frtos-wpan/frtos-wpan/doc/evb/e407-odev.jpg

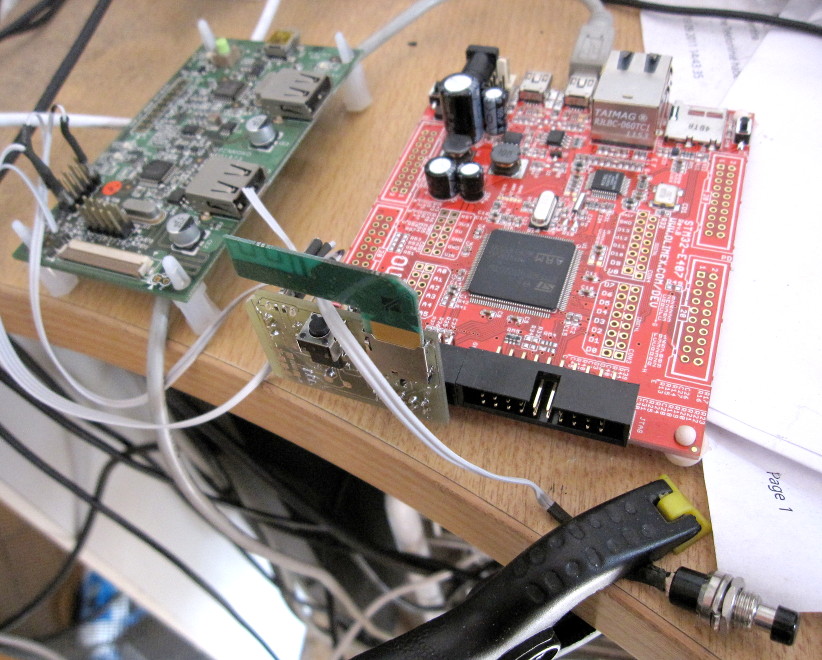
doc/evb/e407-odev.jpg
