frtos-wpan/frtos-wpan/doc/evb/e407-ext.jpg

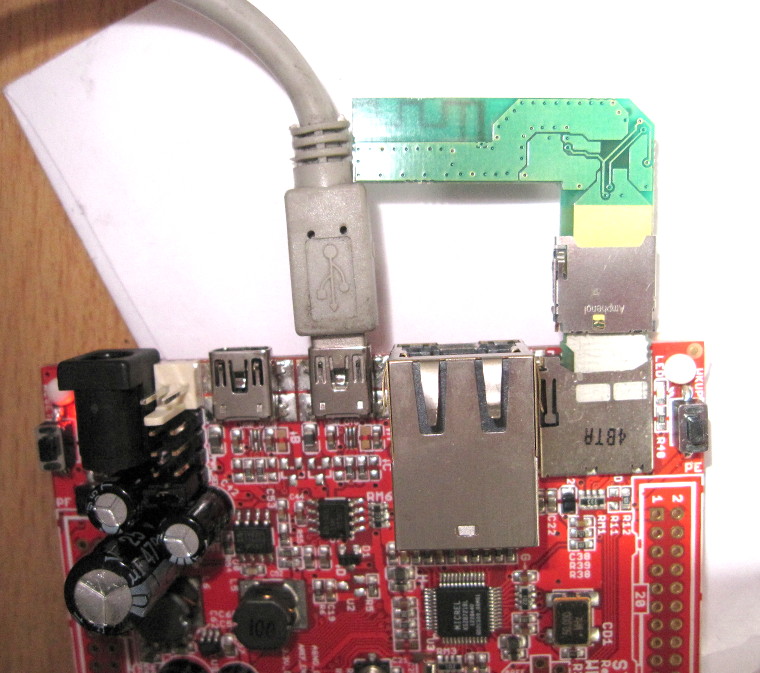
doc/evb/e407-ext.jpg
