frtos-wpan/frtos-wpan/README

@@@ WIP. branch names will change.

@@@ WIP. the github setup is a bit awkward. may change in the future.

README files and other docummentation
-------------------------------------

There is the following documentation:

- README.md gives a brief project overview,

- this file explains what you need to know to use this project,

- doc/toolchain.txt describes how to build a toolchain from sources
  (warning: may not work properly and there's the prebuilt "official"
  ARM toolchain you could just download and/or install),

- doc/devel.txt information for use during the project's development
  process,

- doc/exp.txt experiment setups, configurations, and procedures,
  hardware and software.

License
-------

Unless stated otherwise, all code in this project is developed by 
Werner Almesberger for Actility S.A., and licensed under LGPLv2 by 
Actility S.A.

System setup
------------

Package names are for Ubuntu 13.04.

git-svn is used to track the FreeRTOS upstream (only needed if
maintaining the SVN-to-git tracking repository):

# apt-get install git-svn

The official ARM cross-compilation toolchain
https://launchpad.net/gcc-arm-embedded

# add-apt-repository ppa:terry.guo/gcc-arm-embedded
# apt-get update
# apt-get install gcc-arm-none-eabi

If no package can be found, then change "raring" to "precise" in
/etc/apt/sources.list.d/terry_guo-gcc-arm-embedded-raring.list

We use dfu-util to load new firmware into the evaluation boards:

# apt-get install dfu-util

Other tools we need (some may already be installed):

# apt-get install git make unzip wget

Setting up a FreeRTOS SVN-to-git repository
-------------------------------------------

Note: skip the "git clone ...freertos.git" step in the "Setting up the
repositories" section if you do this.

@@@ verify this sequence

% mkdir freertos
% cd freertos
% git init
% git svn init -T trunk https://svn.code.sf.net/p/freertos/code
% git svn fetch
% git checkout -b master
% git merge --ff-only trunk
% git remote add origin git@github.com:frtos-wpan/freertos.git
#% git push -u origin master
% git config push.default matching
% git push --mirror

Setting up the repositories
---------------------------

% git clone git@github.com:frtos-wpan/frtos-wpan.git 
% git clone git@github.com:frtos-wpan/contiki.git
% git clone git@github.com:frtos-wpan/freertos.git

% cd frtos-wpan
% make

% cd ../contiki
% git remote add upstream https://github.com/contiki-os/contiki.git
% cd ..

Updating the repositories
-------------------------

frtos-wpan:

% cd frtos-wpan
% git pull
% cd ..

Contiki (frtos-wpan fork):

% cd contiki
% git pull
% cd ..

Contiki (upstream):

% cd contiki
% git fetch upstream
% git checkout master
% git merge upstream/master
% git checkout frtos
% git merge master
% cd ..

FreeRTOS (from git):

% cd freertos
% git pull

FreeRTOS (from SVN):

% cd freertos
% git svn fetch
% git merge --ff trunk
% cd ..

Caching the data sheets
-----------------------

Install "dsv" from
http://projects.qi-hardware.com/index.php/p/eda-tools/source/tree/master/dsv
for example,

% git clone git@projects.qi-hardware.com:eda-tools.git
% cp eda-tools/dsv/dsv /usr/local/bin

Download and cache the data sheets:

% cd frtos-wpan
% make

After that, you can access data sheets releveant to the project by going
to any directory under frtos-wpan and invoking "dsv NAME" there. Just
"dsv" lists the available names. The most important ones:

  eval	documentation of the Olimex STM32-E407 data sheet
  f400	STM32F4xx reference manual
  m4	STM32F4xx data sheet
  m4p	Cortex M4 programming manual

@@@ some of the abbreviations are not very good and may change in the
future.
