frtos-wpan/frtos-wpan/doc/evb/e407-atben.jpg

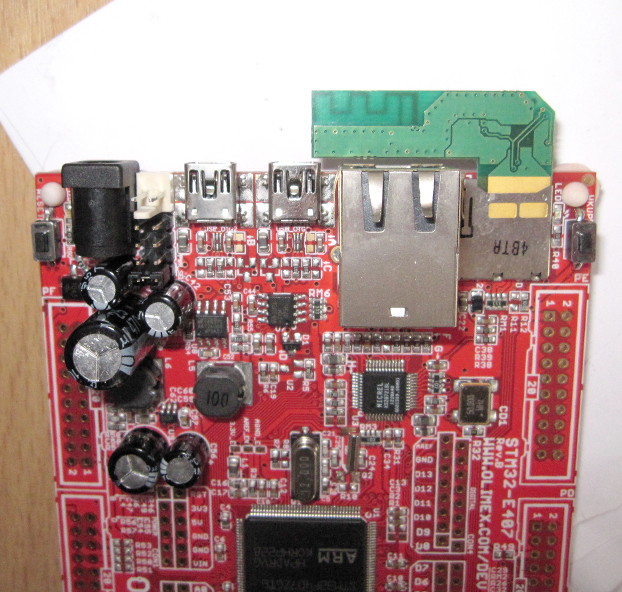
doc/evb/e407-atben.jpg
