frtos-wpan/frtos-wpan/doc/evb/wato-wat9.jpg

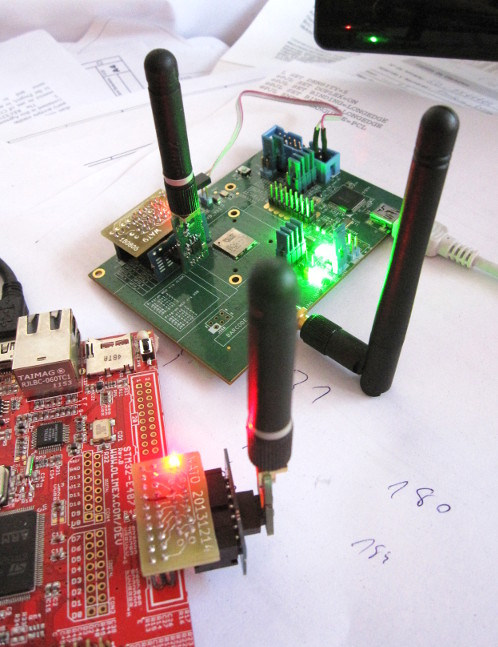
doc/evb/wato-wat9.jpg
