frtos-wpan/frtos-wpan/doc/evb/wm09-dev9.jpg

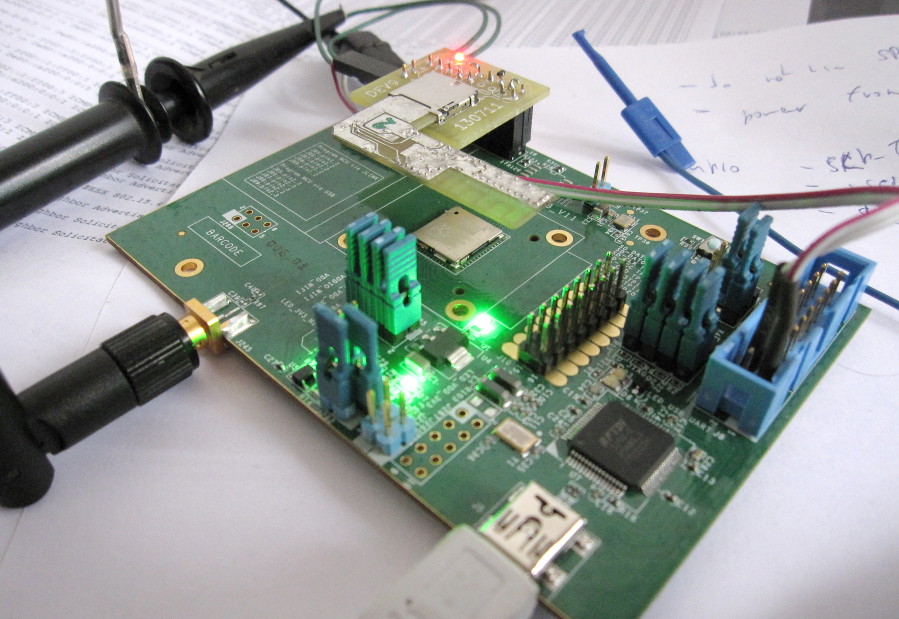
doc/evb/wm09-dev9.jpg
