frtos-wpan/frtos-wpan/lab/atben-gpio/sys-48MHz-nsel-slp_tr.png

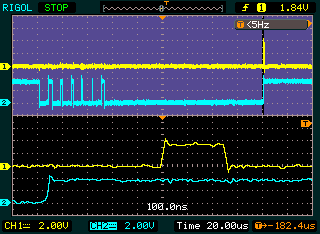
lab/atben-gpio/sys-48MHz-nsel-slp_tr.png
