frtos-wpan/frtos-wpan/lab/atben-gpio/sys-48MHz-sclk.png

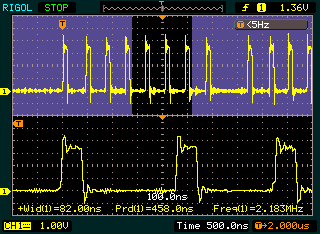
lab/atben-gpio/sys-48MHz-sclk.png
