frtos-wpan/frtos-wpan/lab/atben-gpio/sys-168MHz-nsel-slp_tr.png

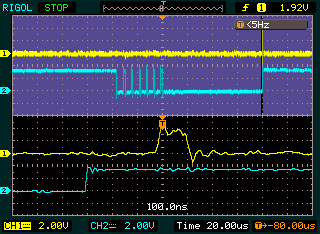
lab/atben-gpio/sys-168MHz-nsel-slp_tr.png
