frtos-wpan/frtos-wpan/lab/atben-gpio/sys-168MHz-sclk-3x.png

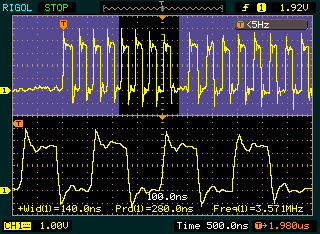
lab/atben-gpio/sys-168MHz-sclk-3x.png
