frtos-wpan/frtos-wpan/lab/atben-gpio/sys-168MHz-sclk.png

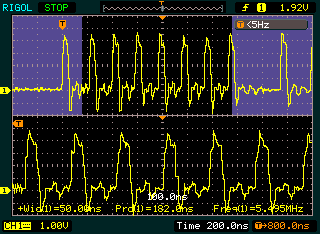
lab/atben-gpio/sys-168MHz-sclk.png
