frtos-wpan/frtos-wpan/lab/atben-spi/spi-buf-read.png

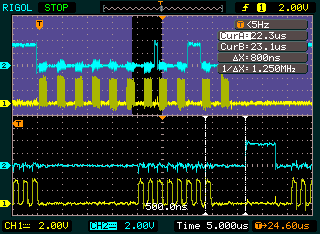
lab/atben-spi/spi-buf-read.png
