frtos-wpan/frtos-wpan/lab/atben-spi/spi-reg-read.png

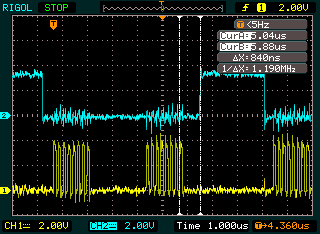
lab/atben-spi/spi-reg-read.png
