frtos-wpan/frtos-wpan/lab/atben-spi/spi-reg-write.png

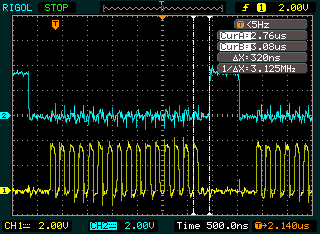
lab/atben-spi/spi-reg-write.png
