frtos-wpan/frtos-wpan/(commit log)

2013-06-14 BOOKSHELF (stm32f400, f400): add STM32F4xx reference manual
2013-06-14 README: add Contiki upstream update, Olimex STM32-E407 board setup
2013-06-14 README: describe the FreeRTOS demo (LED and serial console)
2013-06-14 BOOKSHELF: add STM32 compatibility and F1 to F2 migration documents
2013-06-14 BOOKSHELF (AN3422): STM32F1 to STM32L1 migration
    Useful for getting https://github.com/karlp/contiki-outoftree to work.
2013-06-16 README: add atm-none-eabi toolchain, karlp/contiki-outoftree repository
    These are preparations for bringing up Contiki on the STM32-E407
2013-06-16 README: switch to the official ARM toolchain on Launchpad
    Moving the manual toolchain build process to README.toolchain
2013-06-16 README: use main page as reference to ARM toolchain, not the PPA
2013-06-23 lab/atben-itf/: measurement of atben SPI clock
2013-06-24 README (FreeRTOS repo management): use -ff instead of --ff-only
    ... and remove instructions for what to do when --ff-only fails, which
    is currently the expected outcome.
2013-06-24 doc/exp.txt: correct build instructions of hybrid; add that it blinks the LED
2013-06-29 odev/: atben adapter board for Olimex STM32-E407
    [odev.kicad_pcb, odev.sch]
2013-06-29 odev/: change 8:10 card holder to push-pull type; add pin 1 marking for MCU
    [odev.kicad_pcb, odev.sch]
2013-06-29 odev/odev.kicad_pcb: connect switch on back side, not front
    [odev.kicad_pcb]
2013-06-30 odev/pcb/Makefile: Makefile for PCB production
2013-07-02 TODO: add "submit SLP_TR after frame write fix"
2013-07-03 odev/: change/set USB resistor values: serie 22 -> 68 Ohm; pull-up 1.5 kOhm
    [odev.kicad_pcb, odev.sch]
2013-07-03 lab/atben-spi/: analyze register read timing with SPI interface
2013-07-03 lab/atben-spi/: update register read timing
2013-07-03 lab/atben-spi/: add register write timing
2013-07-03 lab/atben-spi/: add buffer read timing
2013-07-03 TODO: SPI is done, with adapter (ODEV) and driver (for the hybrid)
2013-07-07 TODO: remove debugging output that slows down the rf230 driver
2013-07-09 TODO: track upstreaming of fixes
2013-07-09 TODO: track progress of Contiki submissions
2013-07-09 doc/6lowpan.txt: specify end commit; correct hybrid's address in ping6
    The end commit comes from the switch to using U_ID. Once the dust settles,
    we'll have an address that's hard to predict and need some procedure for
    identifying our destination.
2013-07-10 We can now ping once RPL has done its job. The main problem was frame loss on Linux.
2013-07-11 dev9/: atben adapter board for USI WM-N-BM-09-EVB
    [dev9.kicad_pcb, dev9.sch]
2013-07-11 odev/ (Q1): G and S were swapped, oops
    [odev.kicad_pcb, odev.sch]
2013-07-11 dev9/: tighten layout
    [dev9.kicad_pcb]
2013-07-11 dev9/pcb/Makefile: Makefile for PCB production
2013-07-12 doc/evbs/: evaluation and interface boards
2013-12-16 doc/wm09-recovery.txt: recovery of the WM09 eval board from a "bad" image
2013-12-17 doc/evb/wato-wat9.jpg: STM32-E407 with WATO and USI WM09 with WAT9
